y-morishita-biz/oyobidashi/docs/plate-design.html

oyobidashi · plate · 2026-10-07 · layout B 確定

# M5Dial を埋め込むプレート

展示ブースの机に、地面から 20° で寝かせて置く呼び出しボタンのプレートです。造形範囲 180 × 180 mm 以上の多色対応 3D プリンターで、文字を少し盛り上げて2色で造形します。形は横長 170 × 110 mm、レイアウトは B (上に見出し、下にダイヤルと3ステップ) に確定し、STEP / STL を書き出しました。M5Dial は付属のネジ式のリングでプレートを挟んで留め、左右の側板で支えます。

## レイアウト B に決定

英語、「回すと製品が見られます」、ロゴを外し、見出し・一文・3ステップだけにしました。机に 20° で寝かせて見下ろす置き方なので、プレートの上側が奥、下側が手前になります。左右の灰色の帯 (4 mm) は側板の溝に入る部分で、文字を置いていません。

### A. 左にダイヤル、右に説明

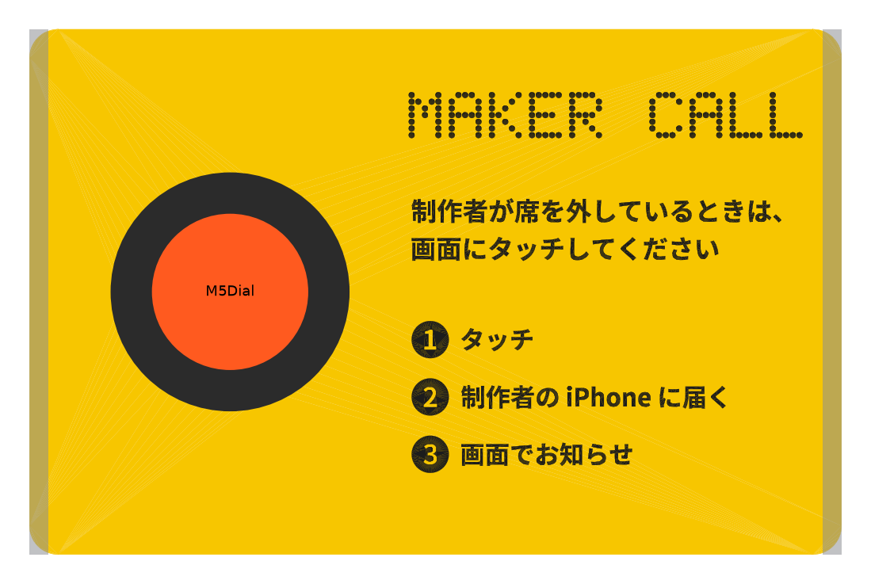
[picture p1: docs/preview_front_A.png]
レイアウト A の正面図


- 前回の案の並びのまま、要素を減らして文字を大きくした
- 見出しが小さめ

決定

### B. 上に見出し、下にダイヤルと3ステップ

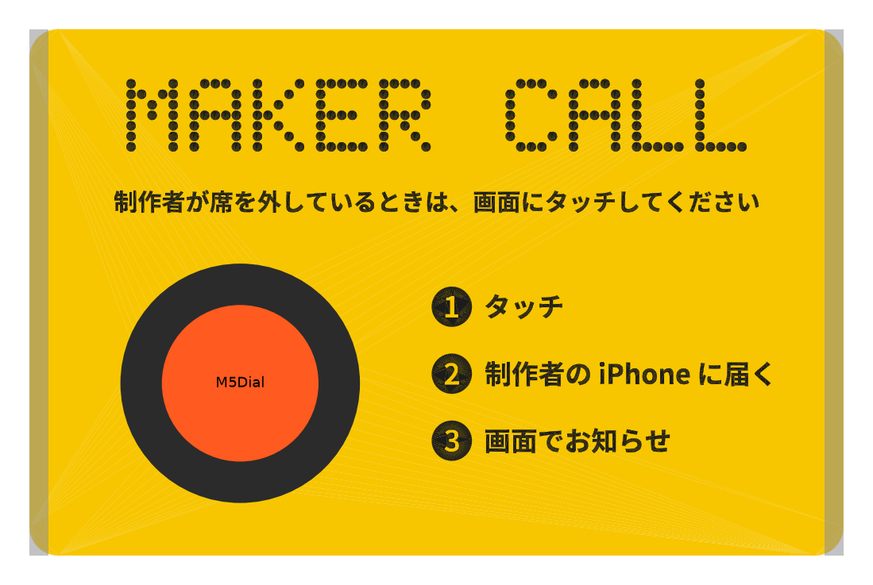
[picture p2: docs/preview_front_B.png]
レイアウト B の正面図


- 奥 (上) の見出しは遠くから目に入り、手前 (下) のダイヤルは手が届きやすい
- 見出しをいちばん大きくできる

### C. 右にダイヤル、左に説明

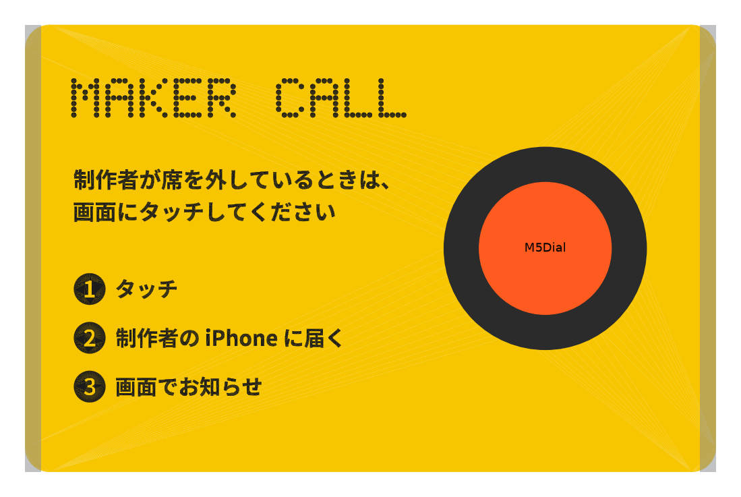
[picture p3: docs/preview_front_C.png]
レイアウト C の正面図


- 右手で触りやすい
- バッテリーは左の裏に貼る

## 3D モデル layout B (確定) · 170 × 110 × 3 mm · 20°

ドラッグで回転、ホイールやピンチで拡大できます。M5Dial・付属のリング・バッテリーは、位置を確かめるための仮の形です (公式データの寸法から作った円柱と箱)。

色

イエロー地 + ブラック文字 ブラック地 + イエロー文字 グレー地 + ブラック文字

視点

正面 斜め 横 背面

M5Dial・バッテリーを表示

読み込み中…

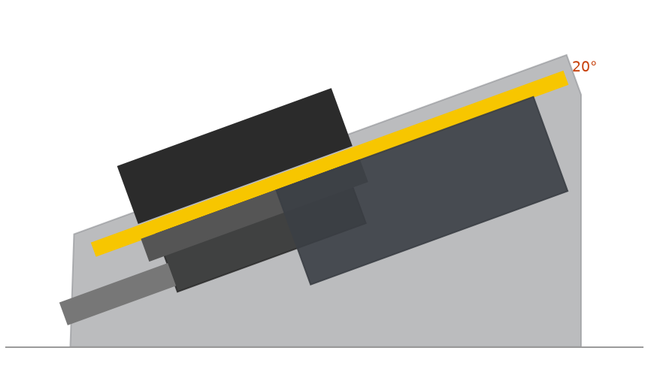
[picture p4: docs/preview_side.png]
横から見た図。プレートが地面から20度で側板に支えられ、裏に M5Dial、付属のリング、USB-C のプラグ、バッテリーがある


横から見た図:プレートの前の端を机から 20 mm 浮かせて、裏の M5Dial の本体、真下へ出る USB-C のプラグ、バッテリーが机に当たらないようにしています。寝かせたので、押しても後ろへ倒れにくくなりました。

## 部品と造形 parts

ファイル | 大きさ | 数 | 色 | 造形
fit_test.stl | 60 × 60 × 3 | 1 | どれでも | 最初に造形する試し板。穴に M5Dial を通し、付属のリングで挟めるか、USB-C が挿せるかを確かめる
plate_base.stl plate_raised.stl | 170 × 110 × 3 + 盛り上げ 0.8 | 1 | 2色 (地 / 文字) | 表を上にして平らに。スライサーで2つを「1つのオブジェクトの複数パーツ」として読み込み、色を割り当てる。色が替わるのは高さ 3 mm の1回だけ
frame_left.stl frame_right.stl | 112 × 64 × 8 | 各1 | グレー | そのままの向き (溝が上)。サポート不要
plate.step frame_left.step frame_right.step fit_test.step | 上の部品の STEP (造形する向き)。plate.step は地と文字が別のボディなので、CAD でも色分けできる
oyobidashi_plate.step | 組み立てた状態の STEP。寸法の確認や、Rhino などでの手直しに

目安の設定:ノズル 0.4 mm、積層 0.2 mm (盛り上げは4層)、壁 3周、インフィル 15%。ファイルは plate/out/、作り直しは plate/make_plate.py (寸法はファイルの先頭。--layout A などでレイアウトを選ぶ)。

## 組み立て assembly

1. M5Dial の背面の、付属のリングを外す
2. M5Dial を、USB-C を下にして前からプレートの穴に差し込み、裏からリングを締めて挟む
3. USB-C ケーブルを挿し、バッテリーをプレートの裏の右上に両面テープで貼るリングを締めてから貼る (バッテリーがあるとリングを回しにくい)
4. 左右の側板の溝に、プレートの左右の端を上 (奥) から差し込む溝の下の端でプレートが止まる。地面から 20° になる
5. 担当者メニューの「画面の向き」で、画面が正面を向くように 10° 刻みで合わせる

## 確かめたいこと before printing

1. 試し板で、挟める厚さを確かめるプレートの厚さ 3 mm、穴 Ø44.6 は公式データからの値です。付属のリングが十分にかかるか、リングを締めたときに USB-C が挿せるか、回るリングがプレートにこすれないかを、試し板で確かめてから本番を造形するのが安全です
2. 色の組み合わせ上のビューアで3通りを比べられます。側板はグレーを想定しています

## 前提 facts

もの | 寸法 | 設計で気をつけること
M5Dial 全体 | Ø51.0 × 奥行 32.3 mm | 公式データ (Dial.stl) と公式仕様から。46 g
回るリング (前面) | Ø49.7、奥行 約10 mm | 製品カードと担当者メニューで回すので、プレートの前に出す
背面のネジ | 外径 Ø44、長さ 約11 mm | プレートの穴に通す。付属のリング (外径 Ø50.8、高さ 5 mm) がナットになり、プレートを挟んで留める
USB-C | 背面の本体の真下 | リングの後ろ側にあるので、プレートが厚いとリングでふさがる。挟める厚さは約 3.5 mm まで
モバイルバッテリー | 92 × 60 × 22 mm、約180 g | 10,000mAh クラスのモバイルバッテリー (作例のサイズ)。背面に両面テープ。重りにもなる
3D プリンター | 造形範囲 180 × 180 mm 以上、2色以上 | 今回は2色。平らな板を、表を下にして造形すると文字がきれい

## 検討の経緯:最初の3つの方向 B 横長に決定

どの案も、文言の役割は同じです。遠くから「何のプレートか」を伝える見出し、近づいた人への一文と3ステップ、M5Dial のまわりの「回せる」サインです。見出しの英語は、画面と同じ 5×7 のドットで描きます。ドットの意匠として、2色目でくっきり出ます。

プレートの色

オレンジ地 + 黒文字 黒地 + 白文字

### A. 縦長の看板

120 × 170 mm · 厚さ 4 mm

- 上から順に読める、いちばん素直な看板
- 3ステップを大きく入れられる
- 背が高いので、立てると少しぐらつきやすい

### B. 横長のサイン

170 × 110 mm · 厚さ 4 mm

- 背が低く安定する。机の手前に置いても視線をさえぎらない
- 左に M5Dial、右に説明。視線の流れが自然
- バッテリーを M5Dial の右の裏に貼れる

おすすめ

### C. 丸いバッジ

Ø150 mm (下を平らに) · 厚さ 4 mm

- 画面の外周の60個のドットが、プレートまで広がったような形。画面とプレートが1つの道具に見える
- ダイヤルの「回せる」サインを、円に沿って自然に入れられる
- 文字の量は少なめ。説明は一文と3ステップに絞る

色の比較:オレンジ地は、待機画面の「オレンジ = 触れる番」をプレート全体に広げる案です。遠くから目に入り、プレートごとボタンに見えます。黒地は、M5Dial の黒いリングと一体に見え、落ち着いた印象です。
