y-morishita-biz/oyobidashi/docs/ux-proposal.html

oyobidashi · UX / UI 仕様 · 2026-10-07 更新

# 触れた瞬間から、制作者が来るまで。

M5Dial をプレートに埋め込んで展示する、ブースの呼び出しボタンの体験設計です。ペルソナ5人の困りごとから原則を決め、画面・音・通知・ダイヤル操作に落とし込みました。このページの内容は実機（call-button ファームウェア）に実装済みで、下のプロトタイプは実機と同じ流れで動きます。

画面そのものがボタンオレンジに光る丸と「制作者と話してみたい！」。触れた瞬間に音と波紋で応える

制作者の返事が画面に届く通知のボタンで「向かいます / 5分で戻ります / 30分で戻ります」。画面に「12:15 ごろ戻ります」と出る

待つ時間を楽しく、短くQR の画面は白地。ダイヤルを回すと製品カード。5分で区切って引き止めない

00前提

展示の形 | M5Dial をプレートに埋め込む。来場者は画面に触れて呼ぶ (押し込みでも反応する)。BIG スイッチは使わない
制作者 | ヨウスケさん1人。トイレ、昼食、ほかのブースへのあいさつで1日に何度も席を外す。iPhone はポケット、会場は騒がしい
通信 | Android のテザリング → ntfy.sh → iPhone の ntfy アプリ。触れてから届くまで約2.5秒
費用 | 無料。NFC カードなど、買い足しが必要な案は使わない
使う部品 | 丸型 240×240 の画面 (タッチ兼押し込みボタン)、ダイヤル (1周16段)、ブザー

01ペルソナ5 people

来場者4人と制作者1人。来場者側は「目的」「待てる時間」「読める言葉」「触れ方」がそれぞれ違う人を選びました。記号は、このあとの原則で誰のための判断かを示します。

K

### ケンタ (34)

ソフトウェアエンジニア。SNS で自作キーボードを見て、作者と話すために来た

「押したけど、これ本当に届いてる?」

したい

作者に直接、設計や入手方法を聞きたい

不安

反応が分からないと、待つべきか帰るべきか決められない

行動

説明は読まずにまず触る。待てるのは5分ほど

必要

届いたこと、来るかどうか、どれくらい待ったか

M

### ミホ (45)

雑貨店のバイヤー。1日で60ブースを回り、取引できそうな出展者だけを深掘りする

「3分待って来なければ次に行きます。連絡先だけほしい」

したい

短い時間で取引できるかを判断したい

不安

来るか分からない人を待つ時間がもったいない

行動

待つ前に「待つ価値があるか」を考える

必要

戻りの目安と、待てないときに持ち帰れるもの

L

### Liam (29)

台湾から来たハードウェア系スタートアップの創業者。日本語はほとんど読めない

"Is this a button? Can I press it?"

したい

仕様と量産について聞きたい

不安

説明が読めず、触っていいものか分からない

行動

形と色、短い英語を頼りに判断する

必要

言葉に頼らない「触れる」見た目と、短い英語の補足

S

### サクラ (8) と父

家族で来場。子どもは光るものを見つけると何度も触る。父は人に迷惑をかけたくない

「触ったら光った! もう1回!」
「すみません、触っちゃって…」

したい

子: 触って何が起きるか見たい。ダイヤルも回したい

不安

父: いたずらで制作者を呼び出してしまうこと

行動

連打する。長押しもする。ダイヤルを回す

必要

何度触っても通知は1回。反応は楽しいまま

Y

### ヨウスケ (制作者)

1人で出展。iPhone をポケットに入れて歩き回る。会場はアナウンスと話し声で騒がしい

「トイレ中に鳴っても、返事だけはすぐしたい」

したい

来てくれた人を逃したくない

不安

通知を見逃すこと。すぐ戻れないときに来場者を待たせ続けること

行動

片手で iPhone を見る。返事に何ステップもかけられない

必要

気づくまで知らせてくれる。ボタン1つで返事。戻ったら簡単に元に戻せる

02体験の原則7 rules

- KSL

### 触れた瞬間に応える

  通信には約2.5秒かかる。その前に0.1秒で音と波紋を返して「触れた」を伝える
- KMY

### 「届いた」と「来る」を分けて見せる

  届いただけでは、制作者が気づいたかは分からない。返事を受けたときだけ「向かっています」「ごろ戻ります」を出す
- MK

### 待つ時間に、目安と楽しみを

  待った時間と戻りの時刻を見せる。QR の画面は白地にして切り替わりを伝え、SNS の QR や製品カードで待つ時間を楽しくする
- KL

### 失敗を来場者に背負わせない

  送れなかったら裏で最大3回やり直す。もう一度触ってもらうのは、全部失敗したときだけ
- LS

### 言葉より先に、形で伝える

  オレンジ = 触れる番、黒 = 待つ番、白 = 見て楽しむ番。回せる画面には時計回りの矢印
- Y

### 制作者の手間はボタン1つ

  通知のボタンがそのまま返事になる。通知を読むためのタップでは返事にしない。戻ったら3秒長押し
- SY

### いたずらしても誰も困らない

  呼び出し中は何度触っても通知を増やさない。メニューは開いた直後「閉じる」を選んでおく

03体験の流れjourney

経過 | 場面 | 画面と音 (来場者) | 制作者 | 感じてほしいこと
− | 見つける | オレンジの丸とドットの「TAP」「制作者と話してみたい！」。ダイヤルを回すと外周の光がついてくる | 席を外している | 触っていいものだ
0.1s | 触れる | 「ピッ」。オレンジの丸が沈み込み、波紋が広がる | − | 触れた
0–2.5s | 呼び出し中 | CALLING。外周のドットが回る | − | 動いている
2.5s | 届いた | 「ピロン」。SENT「制作者に届きました」。外周のドットが1秒ずつ灯る。左右に回す矢印 | 🔔 ブースで呼ばれています | 届いた。時間は進んでいる
1min | 待つ | 白地に変わり、QR と「詳しく見てみる」。回すと製品カード | − | 待つ間も楽しい
2min | 返事がない | 画面はそのまま | 🔔 まだお待ちです (再通知) | (制作者) 見逃しても、もう一度知らせてくれる
任意 | 返事が来る | 「ピンポーン」。COMING「制作者が向かっています」、または白地に大きな時刻「12:15 ごろ戻ります」 | 通知のボタンで返事 | 来るなら待とう / 後で来よう
5min | 区切る | 白地に「お待たせしています」と QR。2分後に待機へ | 来場者に連絡先を案内しました | 放っておかれていない
到着 | 戻る | 制作者が画面を3秒長押し → 待機へ | 来場者と話す | (制作者) 戻すのも一瞬

04触って確かめるprototype

実機と同じ 240×240 の画面と同じ流れです。画面をクリックすると触れたことに、長押しすると制作者の長押しになります。ダイヤルの矢印ボタンで回し、iPhone の通知のボタンで返事ができます。時間を早送りすると、再通知や区切りも確かめられます。

⟲ 回す 回す ⟳

クリック = 触れる / 長押し 3秒 = 待機に戻す / ← → キー = ダイヤル
一番下の小さな点 = Wi-Fi 未接続 (制作者向け)

制作者の iPhone

10:42

展示会 1日目

通知はまだありません。
左の画面に触れてください

通知のボタンで返事。通知を読むだけなら返事にならない

シミュレーション

画面に触れるSpace 制作者が戻る (長押し)3s 担当者メニュー押したまま回す Wi-FiON 音ON

1× 10× 60×

経過 0:00

最初からreset

05画面一覧11 screens

色の意味は3つです。オレンジ = 来場者が触れる番 (待機、失敗)、黒 = 待つ番 (呼び出し中、届いた、向かっています)、白 = QR を見て楽しむ番 (届いて1分後、戻り時刻、お待たせ、製品カード)。大きな英単語と時刻は 5×7 のドットで描きます。日本語は Noto Sans JP (なめらかフォント) です。

06ダイヤル16 detents

来場者がやることは「触れる」だけのまま。ダイヤルは、気づいた人だけが楽しめるおまけと、制作者の隠し操作に使います。

いつ | 操作 | 起きること | 誰のため
待機・在席 | 回す | 外周の光がダイヤルの位置についてくる (1.5秒で消える)。通知は送らない | S L
届いた・向かっています・戻り時刻・お待たせ | 回す | 製品カードがめくれる (Product A / Product B / Product C / Follow us などのサンプル)。8秒触らないと元の画面へ。左右の縁の時計回りの矢印が、2.4秒ごとに少し動いて「回せる」を伝える | K M
いつでも | 画面に触れたまま1段回す → 離す | 担当者メニュー。回して選び、触れて決定。閉じる / 在席にする / 離席にする / 15・30・60分で戻る / 音量 (大・中・小・なし)。開いた直後は「閉じる」、10秒で自動で閉じる | Y

07音buzzer

会場は騒がしいので、音は補助で、主な合図は画面です。再生ボタンで、ブザーに近い音色 (矩形波) を確かめられます。音量は担当者メニューで変えられます。

| いつ | 音 | ねらい
▶ | 触れた瞬間 | ピッ | 触れたことを0.1秒で返す
▶ | 通知が届いた | ピロン | 前向きな合図
▶ | 制作者の返事 | ピンポーン | いちばん目立たせたい知らせ
▶ | 呼び出し中に触れた、カードをめくった | コッ | 反応はするが、目立たせない
▶ | やり直しが全部失敗 | ポッ ポッ | 責める音にしない
▶ | 担当者メニューを開いた | ピポ | 制作者に、隠し操作が効いたことを伝える
▶ | 待機に戻した、メニューで決定した | ピロリ | 同上

08通知iPhone

すべての通知に、返事のボタン「向かいます / 5分で戻ります / 30分で戻ります」が付きます (iPhone では通知を長押しすると出る)。通知そのものをタップしても返事にはならず、ntfy アプリが開くだけです。

いつ | タイトル | 本文 | 優先度
触れて2.5秒 | 🔔 ブースで呼ばれています | 話を聞きたい人がいます！(10:42) | 5
+2min | 🔔 まだお待ちです | 話を聞きたい人がいます！(10:42から・2分経過) | 5
+5min | 来場者に連絡先を案内しました | 5分たったので、画面に QR を出しました | 3
不在中に触れた | 来場者が来ました | ブースで待っている人がいます(11:52)。3分に1回まで。長押しでは送らない | 3

09決定の記録changes

最初の提案から、実機で試しながら変えた点です。

項目 | 最初の提案 | 決定 | 理由
区切り | 10分 | 5分 (再通知は2分の1回) | 10分は来場者には長い
返事の方法 | 通知のタップ | 通知のボタン3つ。タップは返事にしない | 通知を読むためのタップで「向かいます」になってしまった。iPhone でもボタンが使えると確認できた
戻りの表示 | − | 「12:15 ごろ戻ります」(時刻) | 「30分後」だと、あとから来た人には意味がずれる
QR の位置づけ | お急ぎの方はこちら | 詳しく見てみる (自分の SNS やサイト) | 急かすより、待つ間に活動を見てもらう
QR の画面の色 | 黒地 | 白地 | 画面が「変わった」ことが伝わる
呼びかけ | PUSH / 押して担当者を呼ぶ | TAP / 制作者と話してみたい！ | 画面の押し込みは重い。「担当者を呼ぶ」は心理的に呼びづらい
在席の切り替え | NFC カード案あり | 担当者メニュー (触れたまま回す) | 無料方針。カードは付属せず、Suica は読めない
ダイヤル | 来場者向けには使わない | 製品カード、外周の光、時計回りの矢印 | 「触れるだけ」は保ったまま、気づいた人が楽しめる
フォント | BIZ UDP ゴシック (案) | Noto Sans JP のなめらかフォント | 内蔵フォントのギザギザが気になった。使う文字だけを埋め込み、容量も約1MB減った

10設置next

次のステップは、M5Dial を固定して埋め込むプレート (3D プリンターで多色造形) です。画面とダイヤルの操作から決まる条件をまとめておきます。

- タッチ指が画面のガラスに直接触れないと反応しない。アクリルなどで覆わない
- 押し込み画面の押し込みも残す。縁で画面を押さえず、前面を少し出す
- ダイヤル製品カードと担当者メニューで使うので、リングは指で回せるように出しておく
- 傾き机の上で手前に15〜20°傾けると、立った人から画面が見やすく触れやすい
- ケーブルUSB-C は背面へ逃がす。画面の上下の向きとケーブルの出口を合わせる
