y-morishita-biz/oyobidashi/plate/out/frame_left.step

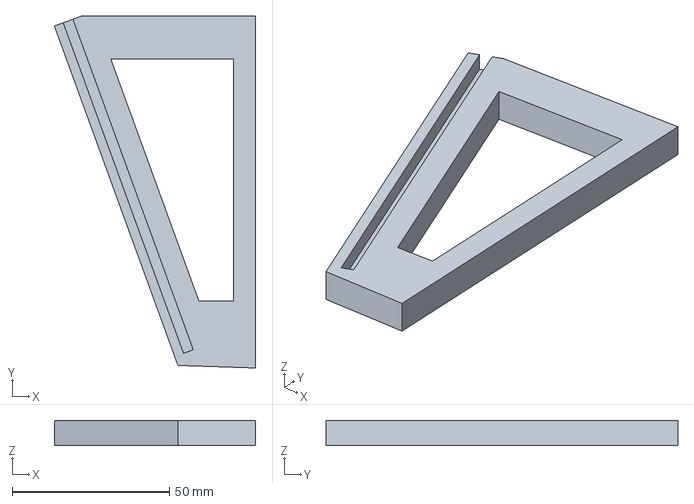
[picture p5: CAD file, 2026-10-07]
plate/out/frame_left.step
64.1 x 112.1 x 8.00 mm
