y-morishita-biz/oyobidashi/plate/out/oyobidashi_plate.step

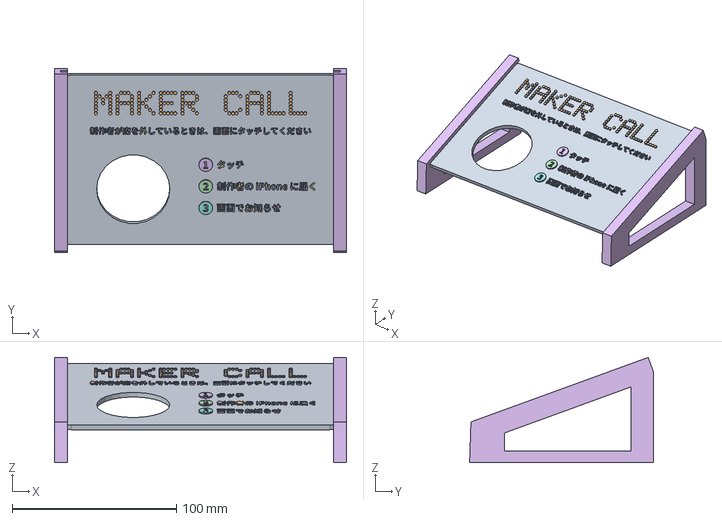
[picture p6: CAD file, 2026-10-07]
plate/out/oyobidashi_plate.step
178.0 x 112.1 x 64.1 mm
