y-morishita-biz/oyobidashi/plate/out/plate.step

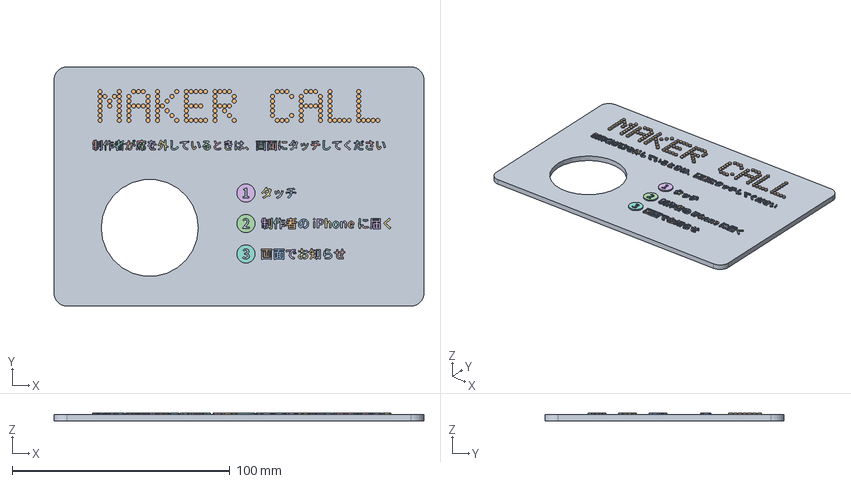
[picture p7: CAD file, 2026-10-07]
plate/out/plate.step
170.0 x 110.0 x 3.80 mm
