y-morishita-biz/oyobidashi/plate/out/fit_test.step

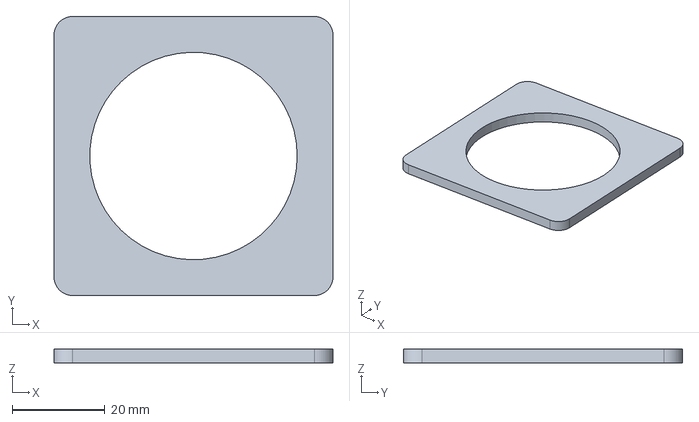
[picture p8: CAD file, 2026-10-07]
plate/out/fit_test.step
60.0 x 60.0 x 3.00 mm
