y-morishita-biz/oyobidashi/plate/out/plate_raised.stl

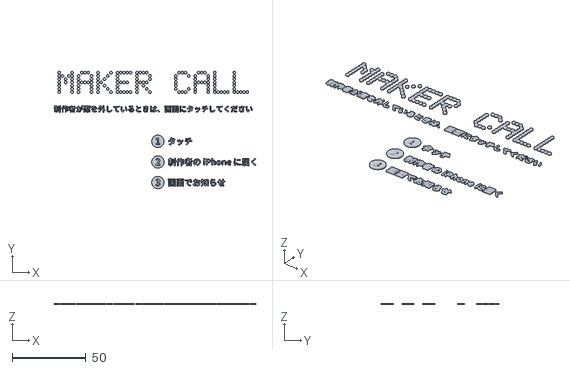
[picture p9: CAD file, 2026-10-07]
plate/out/plate_raised.stl
137.1 x 79.8 x 0.8
