y-morishita-biz/oyobidashi/plate/out/plate_base.stl

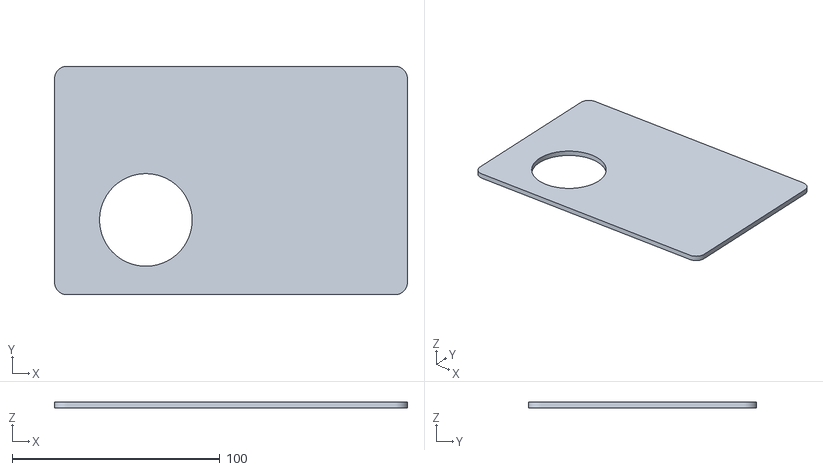
[picture p10: CAD file, 2026-10-07]
plate/out/plate_base.stl
170.0 x 110.0 x 3.00
