y-morishita-biz/oyobidashi/(list of files, cad)

Other CAD files:
plate/out/frame_right.step
plate/out/fit_test.stl
plate/out/frame_left.stl
plate/out/frame_right.stl
