y-morishita-biz/oyobidashi/docs/setup/event-checklist.md

# 4. 当日のチェックリスト

## 前日まで

- [ ] M5Dial にファームウェアを書き込み、自宅で通知・返事が届くことを確かめた
- [ ] モバイルバッテリーを満充電にした（2ポートあると楽）
- [ ] ブース用スマホを満充電にした
- [ ] 持ち歩くスマホで、集中モード中にも通知が届くか試した
- [ ] Mac を使う人は、iPhone の 設定 → 通知 → ntfy で「Mac に表示」をオフにした（[理由](receiver-ntfy.md#mac-を使っている人はmac-に表示をオフにする)）
- [ ] QR コードの行き先（設定モード、または `call-button/src/main.cpp`）と製品カードを、その展示会向けにした

## 会場で設営するとき

- [ ] ブース用スマホのテザリングをオン（2.4GHz・自動オフなし）
- [ ] ブース用スマホと M5Dial をモバイルバッテリーにつなぐ
- [ ] M5Dial の画面の一番下に小さな点が出ていない（＝ Wi-Fi につながっている）
- [ ] 画面に触れて、持ち歩くスマホに通知が届く
- [ ] 通知を長押しして「向かいます」を押し、M5Dial に「向かっています」と出る
- [ ] 画面を3秒長押しして待機に戻す
- [ ] 担当者メニュー（画面に触れたままダイヤルを1段回して離す）で音量と画面の向きを合わせる

## 担当者メニューの使い方

| 操作 | 内容 |
|---|---|
| 在席にする | ブースにいるあいだ。触れられても通知しない（60分で自動で待機に戻る） |
| 離席にする | 待機に戻す |
| 15・30・60分で戻る | 画面に戻る時刻を出す。触れられると目立たない通知が来る |
| 音量・画面の向き | 本体に保存される |

## 撤収するとき

- [ ] テザリングをオフにする
- [ ] 次の展示会まで間が空くなら、トピック名を作り直してもよい（[SECURITY.md](../../SECURITY.md)）
