y-morishita-biz/oyobidashi/call-button/include/secrets.example.h

// このファイルを secrets.h にコピーして、テザリングの SSID / パスワードと ntfy のトピック名を入れる。
// secrets.h は .gitignore 済み。トピック名は合言葉の代わりなので、推測されにくい文字列にする。
#pragma once
#define WIFI_SSID "your-tethering-ssid"
#define WIFI_PASS "your-password"
#define NTFY_TOPIC "oyobidashi-xxxxxxxxxxxxxxxx"
