y-morishita-biz/oyobidashi/battery-test/include/secrets.example.h

// このファイルを secrets.h にコピーして、テザリングの SSID とパスワードを入れる。
// secrets.h は .gitignore 済み。secrets.h が無い場合は Wi-Fi オフのままテストする。
#pragma once
#define WIFI_SSID "your-tethering-ssid"
#define WIFI_PASS "your-password"
