y-morishita-biz/oyobidashi/(commit log)

2026-10-07 battery-test を PlatformIO で実機確認し、引き継ぎ資料を追加
    - CLAUDE.md と docs/handoff.md(引き継ぎ資料)を追加
    - battery-test: M5Unified 0.2.x が Serial.begin() を呼ばずシリアルに何も
    出なかったため、cfg.serial_baudrate を明示
    - tools/serial_log.py: 決まった秒数だけシリアルログを読むスクリプト
    (pio device monitor は対話的で止まらず、macOS に timeout も無いため)
2026-10-07 call-button: ntfy で通知を送るところまで作成
    - 画面のボタン / BIG スイッチ(G1)で ntfy.sh に JSON で POST する
    - 送信は別タスクで行い、送信中も画面を描き続ける
    - 送信後60秒は再送しない。失敗時はもう一度押すと再送
    - ISRG Root X1 / X2 で ntfy.sh の証明書を確かめる
    - Wi-Fi の自動再接続と「Wi-Fi 未接続」表示
    - 画面は仮(M5GFX 内蔵の日本語フォント)
    - handoff.md に通知の文言と日本語表記の方針を記録
2026-10-07 call-button: 通知の本文に押された時刻を付ける
    - Wi-Fi 接続時に NTP(ntp.nict.jp / pool.ntp.org)で日本時間を合わせる
    - 押された瞬間の時刻を「話を聞きたい人がいます！(10:42)」の形で送る
    - 時刻が取れていないときは時刻なしで送る
    - README に「Use another server」はオフのままでよいことを追記
2026-10-07 handoff: バッテリーテストと call-button の実機確認の結果を記録
    - バッテリーで約22分動き続け、自動オフは起きなかった
    - call-button を M5Dial に書き込み、テザリング経由で iPhone に
    時刻付きの通知が届くことを確認した
    - 次にやること(BIG スイッチの配線、画面と機能の検討)を整理
2026-10-07 call-button: UX 提案に沿って画面・音・返事・ダイヤル操作を作り直す
    - 画面7種類(待機・呼び出し中・届いた・向かっています・不在・お待たせ・失敗・在席)と音6種類
    - 押した瞬間の反応、送れなかったときの自動やり直し(最大3回)、連打で通知を増やさない
    - 通知のボタン(向かいます / 5分で戻ります / 30分で戻ります)の返事を待ち受けて画面に出す
    - 戻り時刻は「12:15 ごろ戻ります」と時刻で表示。不在中に押されたら目立たない通知
    - 1分で QR、2分で再通知、5分で区切り。QR の画面は白地
    - ダイヤル: 担当者メニュ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
2026-10-07 call-button: Noto Sans JP のなめらかフォント、白地の長押し、ダイヤルの矢印
    - tools/make_vlw.py: ソースの文字列から使う文字だけを集めて VLW を作る
    - Noto Sans JP(Bold 20/15、Regular 13/11)を埋め込み、内蔵フォントを外す(Flash 48% → 38%)
    - 不在・お待たせの画面でも3秒長押しで待機に戻す。白地では進み具合を黒で描く
    - 不在中の「来場者が来ました」と、お待たせからの呼び出しは、短く触れたときだけ送る
    - 製品カードを見られる画面に、時計回りの矢印を左右の縁に出す
2026-10-07 docs: 提案ページ・README・引き継ぎ資料を実装に合わせて更新
    - docs/ux-proposal.html: 実機と同じ動きのプロトタイプ、画面11種類、ダイヤル、決定の記録
    - call-button/README.md: 操作・状態・返事のボタン・フォントの作り直し方
    - docs/handoff.md: call-button の完成と、次のステップ(プレート)
2026-10-07 call-button: 担当者メニューに「画面の向き」(10°刻み)を追加
    プレートへの取り付けの向きに合わせて画面を回せるようにする。
    選んで触れると調整モードになり、ダイヤルで 10° ずつ回してもう一度触れると決定。本体に保存する。
2026-10-07 plate: M5Dial を埋め込むプレート(B 横長)の 3D モデルと設計ページ
    - plate/make_plate.py: build123d でプレート(地と盛り上げた文字を別の STL)、押さえのリング、足を作り、STL / STEP を書き出す
    - plate/render_preview.py: 正面図と横から見た図の PNG
    - plate/make_viewer_data.py: docs/plate-design.html の 3D ビューア用データ
    - docs/plate-design.html: 3案の検討、決定した B の 3D ビューア、部品と造形、組み立て
    - CLAUDE.md / handoff.md: plate/ の追加と次にやること
    [clamp_ring.stl, foot.stl, plate_base.stl, plate_raised.stl]
2026-10-07 plate: ネジ式のリングで固定、20° の側板、日本語だけのレイアウト3案
    - 押さえのリングとねじ穴をやめ、M5Dial 付属のネジ式のリングでプレート(3 mm)を挟む。穴 Ø44.6
    - 差し込み式の脚をやめ、左右の側板の溝でプレートを地面から 20° に支える
    - 英語・ダイヤルの説明・ロゴを外し、レイアウト A / B / C を作れるように
    - fit_test.stl(60 mm 角の試し板)を追加
    - docs/plate-design.html: レイアウト比較、3D ビューアを新しい構造に、文字化け対策(文字コードの指定、部品名を英字に)
    [clamp_ring.stl, fit_test.stl, foot.stl, frame_left.stl, frame_right.stl, plate_base.stl, plate_raised.stl]
2026-10-07 plate: レイアウト B で確定し、STEP を書き出す
    - plate.step(地と文字を別ボディ)、frame_left / frame_right / fit_test の STEP を追加
    - 組み立てた状態の oyobidashi_plate.step も git で管理する
    - docs/plate-design.html: B に決定、STEP の一覧、確認事項からレイアウトを外す
    - docs/handoff.md / CLAUDE.md: 確定した内容と、タッチで呼ぶ今の方針に合わせて更新
    [fit_test.step, frame_left.step, frame_right.step, oyobidashi_plate.step, plate.step, plate_raised.stl]
2026-10-07 chore: .DS_Store を git の対象から外す
2026-11-01 docs: 公開に向けて README・設定ガイド・SECURITY と秘密情報チェックを追加
    - README.md：概要・用意するもの・はじめかた
    - docs/setup/：ファームウェア書き込み、テザリング（Android / iPhone）、ntfy アプリ（iPhone / Android）、当日のチェックリスト
    - SECURITY.md：秘密情報の置き場所、ntfy 公開トピックのリスク、漏れたときの手順
    - tools/check_secrets.sh と pre-commit フック、GitHub Actions の secret-guard
    - LICENSE（MIT）と THIRD_PARTY_NOTICES.md（Noto Sans JP は OFL 1.1）
    - .gitignore で secrets.h をリポジトリ全体で除外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
2026-11-01 docs: 図を Mermaid にし、設定ガイドを手作業の手順に書き直す
    - README と docs/setup/README の構成図を Mermaid のフロー図・シーケンス図に
    - firmware.md：VS Code + PlatformIO の画面操作で進める手順に（Upload・Serial Monitor ボタン、secrets.h の作り方）
    - tethering.md：ブース用スマホは Android / iPhone どちらでもよいことを明記し、比較表を追加。「作者の運用」を「運用の一例」に
    Claude-Session: https://claude.ai/code/session_01LUJrRYDsQdTJf6Zqnnoy32
2026-11-01 docs: 初めて触る人を想定して設定ガイドを見直す
    - 持ち歩くスマホ・パソコンを特定の機種に寄せず、iPhone / Android、Windows / macOS を並べて書く
    - 設定ガイドに言葉の説明（テザリング・SSID・ntfy・トピックなど）を追加
    - トピック名の作り方に Windows（PowerShell）を追加し、Web の生成サイトを使わないよう注意書き
    - フォントの作り直しを Windows / macOS どちらでも同じファイル配置でできる手順に
    - 初期値は作者のブース用のサンプルであり、変えなくても動くことを明記
    Claude-Sess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
2026-11-01 docs: Yomiyasu の観点で公開ドキュメントを読みやすく整える
    - 初めての読者向けに、M5Dial・テザリングの説明を README に添え、言葉の説明へのリンクを足す
    - 太字のラベルとコロン、行末のコロン、手順や理由を入れた括弧を文に直す
    - 見出しの「について」と括弧の補足を外す
    - 太字の多用を減らし、句点を太字の外に出す
    Claude-Session: https://claude.ai/code/session_01LUJrRVhRGdAxHiYHnf9EUP
2026-11-01 docs: iPhone の「Mac に表示」がオンだと通知が iPhone の画面に出ない注意を足す
    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
2026-11-01 chore: 固有の製品名・SNS・機材の商品名をサンプルに置き換える
    - call-button：製品カードを Product A〜C / Follow us に、QR の行き先を example.com に。QR の下の文字を QR_CAPTION / QR_LABEL の定数にまとめた（使う文字は既存フォントの範囲内なのでフォントの作り直しは不要）
    - ux-proposal.html のプロトタイプも同じサンプルに
    - plate-design.html / handoff.md / plate のスクリプト：3D プリンター・スライサー・モバイルバッテリー・キースイッチの商品名を一般名に、ロゴの仮置きを LOGO に
    - README と firmware.md の説明を合わせる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
2026-11-03 feat: 配布用のファームウェアとブラウザ書き込み・かんたんセットアップを用意する
    部材を持っている人がツールを入れずに使えるようにする。
    - call-button に設定モードを追加（portal.cpp）。M5Dial が Wi-Fi の親機になり、
    スマホのブラウザからテザリング・トピック名・QR の行き先を入れて NVS に保存する。
    設定がないとき、または画面を押したまま電源を入れたときに入る
    - 配布用のビルド env:release（secrets.h を読まない・サンプルの製品カードなし・
    QR は設定したときだけ出す）と、配布ファイルを作る tools/merg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
2026-11-03 docs: 配布版・書き込みページ・設定モードを実機未検証のトライアル版と明記する
    作者は実機で試さないため、おまけ扱いであることを README・手順書・
    書き込みページ・リリースの説明に書き、リリースはプレリリースにする。
    Claude-Session: https://claude.ai/code/session_01LUJrRXLidgWR3SeNBotjDW
2026-11-03 ci: 書き込みページの公開を main で動く pages.yml に分ける
    GitHub Pages の公開先（github-pages 環境）は標準で main ブランチからしか
    受け付けず、タグのビルドから直接公開すると弾かれるため、firmware.yml の
    成功を受けて main 側で公開するワークフローに分ける。
    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
2026-11-03 ci: リリースを main からの Run workflow（version 入力）で作るようにする
    タグのプッシュをやめ、Actions の Run workflow で version を入れて実行すると、
    タグ・プレリリース・書き込みページの公開までを main から行う。
    Pages の公開先は main からしか受け付けないので、pages.yml は不要になった。
    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
2026-11-03 docs: 公開前の読みやすさと安全面を見直す
    - 新しく書いた手順書・README・リリースの説明・書き込みページを読みやすく直す
    （太字のラベルとコロン、手順や理由を入れた括弧を文に直す）
    - SECURITY.md に、設定モードを人に書き換えられるおそれと、
    書き込みページが外部（unpkg.com）から部品を読み込むことを追記
    - 引き継ぎ資料から、外からは開けないアーティファクトのリンクを外す
    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
2026-11-03 docs: 作者の表記を SNS と同じモリシタヨウスケ／ヨウスケさんにそろえる
    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
